kutschl/f1tenth_build/Powerboard/img_9658.jpg

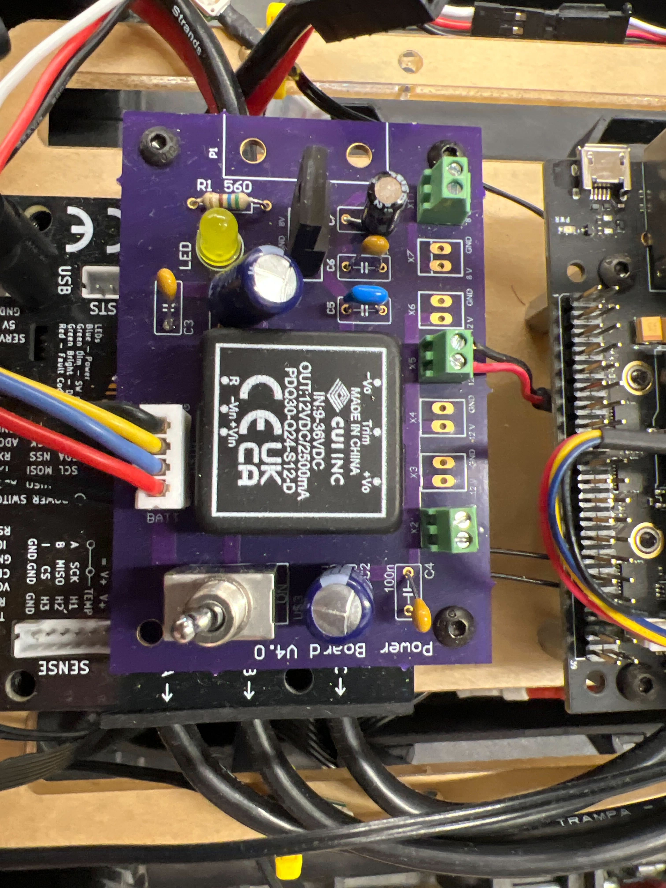
Powerboard/img_9658.jpg
