kutschl/f1tenth_build/Powerboard/IMG_9661.jpg

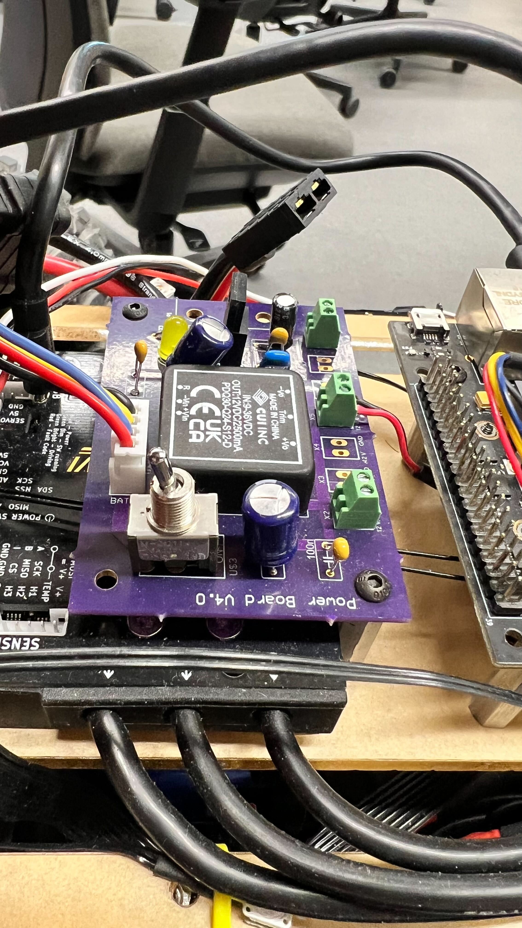
Powerboard/IMG_9661.jpg
