kutschl/f1tenth_build/Powerboard/IMG_9659.jpg

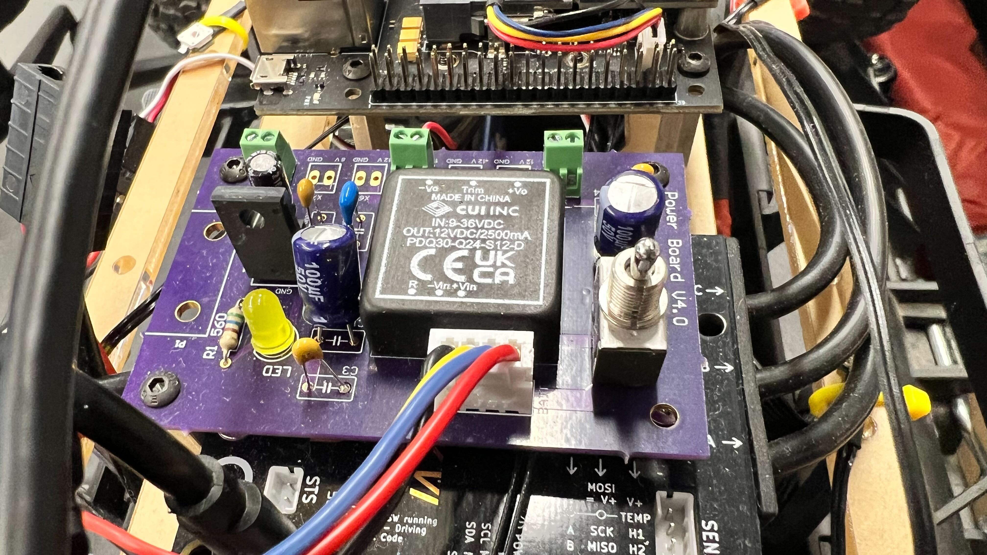
Powerboard/IMG_9659.jpg
