kutschl/f1tenth_build/Powerboard/IMG_9660.jpg

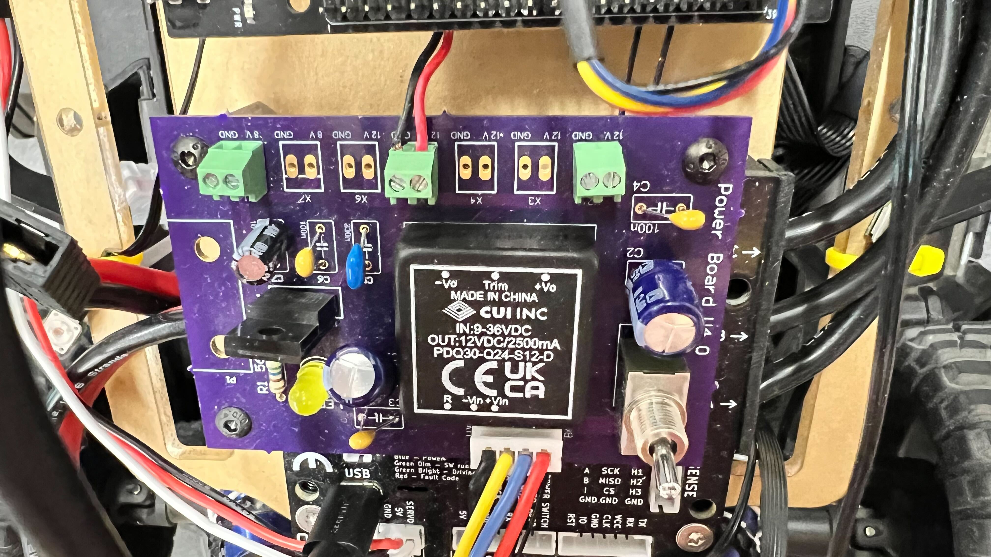
Powerboard/IMG_9660.jpg
