kutschl/f1tenth_build/Powerboard/IMG_9662.jpg

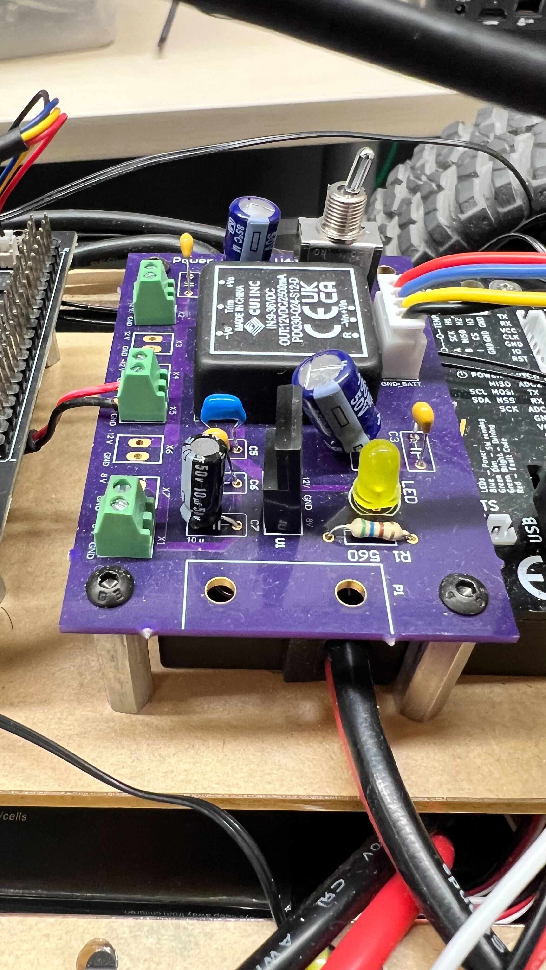
Powerboard/IMG_9662.jpg
