kutschl/f1tenth_build/BOM Orin NX.xlsx

Sheet: Orin NX Slash
Item | Qty. | Costs per Unit | Total Costs | Comments | Product Link | Shopping Link
Chassis
Traxxas TRX68077-4 Slash 4x4 Ultimate TQi 2,4GHz Link Wireless Modul, TSM | 1 | 499.95 € | 499.95 € |  | https://traxxas.com/products/models/electric/slash-4x4-ultimate | https://www.monsterhopups.de/Traxxas-TRX68086-4-Slash-1/10-4x4-Brushless-TQi-mit-Stabilitaetskontrolle-TSM
Traxxas TRX7437 Skidplate, Front | 1 | 6.26 € | 6.26 € |  | https://traxxas.com/products/parts/7437 | https://www.monsterhopups.de/Traxxas-TRX7437-Skid-Platte-vorn
Traxxas TRX7436 Body Bumper, Foam | 1 | 5.36 € | 5.36 € |  | https://traxxas.com/products/parts/7436 | https://www.monsterhopups.de/Traxxas-Schaumstoff-Stossfaenger-TRX-Rally
Traxxas TRX7415X Body mounts, front & rear/ body post, rear | 1 | 8.06 € | 8.06 € |  | https://traxxas.com/products/parts/7415X | https://www.monsterhopups.de/Traxxas-TRX7415X-Karosseriehalter-Set-vorne-hinten-fuer-Rally-VXL-1-10
Antenna Mount | 1 |  |  | self-print
Platform Deck | 1 |  |  | self-print
Depth Camera Mount | 1 |  |  | self-print
Compute Module
Computing Module: reComputer J4012 NVIDIA Jetson Orin NX Bundle 16 GB | 1 | 977.90 € | 977.90 € |  | https://www.seeedstudio.com/reComputer-J4012-p-5586.html | https://www.reichelt.de/nvidia-jetson-orin-nx-bundle-8x-2-ghz-16-gb-ddr5-jetson-orin-4012-p350587.html
WLAN Kit: Shuttle WLN-M1 | 1 | 49.95 € | 49.95 € |  | https://www.shuttle.eu/de/products/accessories/wlnm1 | https://www.reichelt.de/wlan-ax-bluetooth-kit-m-2-fuer-shuttle-barebones-shuttle-wln-m1-p329590.html
Sensors
Lidar: Hokuyo UST-20LN | 1 | 3337.18 € | 3337.18 € |  | https://hokuyo-usa.com/products/lidar-obstacle-detection/ust-20ln | https://eu.robotshop.com/de/products/hokuyo-ust-20ln-scanning-laser-obstacle-detection-sensor-eu
Depth Camera: Intel RealSense D435i | 1 | 369.00 € | 369.00 € |  | https://www.reichelt.de/tiefenkamera-intel-realsense-d435i-3d-kamera-intel-d435i-p275192.html | https://www.intelrealsense.com/depth-camera-d435i/
Electronics
ESC: Trampa VESC 6 MkVI | 1 | 267.17 € | 267.17 € |  | https://trampaboards.com/vesc-6-mkv-in-cnc-t6-silicone-sealed-aluminium-box-with-genuine-xt90-connectors--vedder-electronic-speed-controller-trampa-special-p-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 | https://trampaboards.com/vesc-6-mkv-in-cnc-t6-silicone-sealed-aluminium-box-with-genuine-xt90-connectors--vedder-electronic-speed-controller-trampa-special-p-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
Controller: SONY Dualshock 4 | 1 |  |  | for teleop |  | https://www.playstation.com/de-de/accessories/dualshock-4-wireless-controller/
Charger + LiPo Batteries: Traxxas TRX2990 Battery/Charger Complete Pack | 1 | 249.95 € | 249.95 € |  | https://traxxas.com/products/parts/2990 | https://www.monsterhopups.de/Traxxas-TRX2990GX-POWER-PACK-Dual-EZ-Peak-Plus-Ladegeraet-2x-ID-LiPo-111V-5000mah-25C
LiPo Adapter: Traxxas TRX2938X Balance Lead Adapter | 1 | 24.99 € | 24.99 € |  | https://traxxas.com/products/parts/2938X | https://www.monsterhopups.de/Traxxas-TRX2938XX-2938X-ID-Ladekabel-LiPo-Akku-auf-Balancer-Board-2S-bis-4S-XH
PPM Extension Cable: Trampa Maytech to VESC | 1 | 2.97 € | 2.97 € |  | https://trampaboards.com/maytech-to-vesc-150mm-ppm-extension-cable--silicon-cable-24-awg-blackredwhite-p-24329.html | https://trampaboards.com/maytech-to-vesc-150mm-ppm-extension-cable--silicon-cable-24-awg-blackredwhite-p-24329.html
Barrel Jack to Pigtail 12V 5A | 1 | 4.20 € | 4.20 € | connect Jetson with Powerboard |  | https://www.reichelt.de/adapterkabel-2000-mm-dc-stecker-auf-freies-ende-dc-aks-7521-p150125.html
USB to Micro-USB Cable | 1 |  |  | connect VESC with Jetson
Power Adapter: 12V 5A | 1 |  |  | for Jetson
TRX-XT90-Adapter | 1 |  |  | we soldered a TRX input to the lipo adapter instead of using the TRX-XT90-adapter
Bullet Adapter (4mm Male to 3.5mm Female) | 1 | 9.99 € | 9.99 € | connect VESC with motor |  | https://www.amazon.de/dp/B0BFHWWKX6
Misc
LiPo Safety Bag: 230 x 300 mm | 2 | 11.95 € | 23.90 € |  |  | https://www.reichelt.de/brandschutzbeutel-fuer-li-polymer-akkus-lipo-guard-xl-p207644.html
Header Pins | 1 | 0.64 € | 0.64 € | connect Servo with VESC |  | https://www.digikey.de/en/products/detail/samtec-inc/TS-103-T-A/1105491
Fasteners
Standoff M3 FF 25mm
Standoff M3 FF 35mm
Standoff M3 FF 45mm
Screw M3 10mm
Screw M5 20mm
Powerboard
PCB: F1/10 Powerboard V4.0 | 1 | 27.77 € | 27.77 € |  |  | https://oshpark.com/shared_projects/qvIKu3aY
RES 560 OHM 5% 1/4W AXIAL | 1 | 0.09 € | 0.09 € |  |  | https://www.digikey.de/short/nf19zmv4
CAP CER 0.33UF 100V X7R RADIAL | 1 | 0.52 € | 0.52 € |  |  | https://www.digikey.de/short/857dbcvr
CAP CER 0.1UF 50V X7R RADIAL | 3 | 0.21 € | 0.63 € |  |  | https://www.digikey.de/short/z0pr7pvf
CAP ALUM 100UF 20% 50V RADIAL | 2 | 0.39 € | 0.78 € |  |  | https://www.digikey.de/short/thzvmjdj
CAP ALUM 10UF 20% 50V RADIAL | 1 | 0.23 € | 0.23 € |  |  | https://www.digikey.de/short/8tjjfrt5
IC REG LINEAR 5V 1A TO220CP-3 | 1 | 1.41 € | 1.41 € | original product is not longer available: https://www.digikey.de/short/0jrzbw3b BA7808CP-E2 |  | https://www.digikey.de/short/7m437cwh
DC DC CONVERTER 12V 30W | 1 | 39.32 € | 39.32 € |  |  | https://www.digikey.de/short/dhf4chv7
TERM BLK 2P SIDE ENT 2.54MM PCB | 7 | 0.85 € | 5.95 € |  |  | https://www.digikey.de/short/r0frvb94
SWITCH TOGGLE SPST 6A 125V | 1 | 2.54 € | 2.54 € |  |  | https://www.digikey.de/short/53wnj59d
CONN HEADER VERT 4POS 2.5MM | 1 | 0.20 € | 0.20 € |  |  | https://www.digikey.de/short/fhrdjn8v
LED RED DIFFUSED T-1 3/4 T/H | 1 | 0.68 € | 0.68 € |  |  | https://www.digikey.de/short/9qcj209n
TOTAL |  |  | 5917.59 €

Sheet: Powerboard Breakdown
Item | Components | Qty.
PCB: F1/10 Powerboard V4.0 |  | 1
RES 560 OHM 5% 1/4W AXIAL | R1 | 1
CAP CER 0.33UF 100V X7R RADIAL | C5 | 1
CAP CER 0.1UF 50V X7R RADIAL | C6, C3, C4 | 3
CAP ALUM 100UF 20% 50V RADIAL | C1, C2 | 2
CAP ALUM 10UF 20% 50V RADIAL | C7 | 1
IC REG LINEAR 5V 1A TO220CP-3 | U1 | 1
DC DC CONVERTER 12V 30W | U$9 | 1
TERM BLK 2P SIDE ENT 2.54MM PCB | X1, X2, X3, X4, X5, X6, X7 | 7
SWITCH TOGGLE SPST 6A 125V | U$3 | 1
CONN HEADER VERT 4POS 2.5MM | U$10 | 1
LED RED DIFFUSED T-1 3/4 T/H | LED1 | 1

Sheet: Fasteners Breakdown
Item | Qty.
Antenna Mount to Platform
Standoff M3 FF 45mm | 2
Screw M3 10mm | 4
VESC to Platform
Screw M5 20mm | 2
Powerboard to Platform
Screw M3 10mm | 8
Standoff M3 FF 25mm | 4
Lidar to Platform
Screw M3 10mm | 4
Jetson to Platform
Standoff M3 FF 35mm | 4
Screw M3 10mm | 8
Platform to Body
Standoff M3 FF 45mm | 4
Screw M3 10mm | 8
