kutschl/f1tenth_build/Powerboard/BOM_AE170_PDU_02.04.xlsx

Sheet: BOM_AE170_PDU_02.02
Sr.# | Quantity | Designator | Description | PCB Footprint | Manu Part Number | Manufacturer | Vendor-1 | Vendor-1 Part Number | Vendor-2 | Vendor-2 Part Number
1 | 12 | C1, C11, C19, C21, C24, C28, C36, C38, C41, C43, C45, C49 | CAP CER 0.1UF 100V X7R 0603 | 0603 | CC0603KRX7R0BB104 | YAGEO | DIGIKEY | 311-1523-1-ND | MOUSER
2 | 8 | C2, C3, C6, C7, C34, C35, C44, C48 | CAP CER 10UF 50V X5R 0805 | 0805 | GRM21BR61H106KE43L | Murata Electronics | DIGIKEY | 490-18663-1-ND | FARNELL
3 | 3 | C4, C5, C8 | CAP CER 10000PF 50V X7R 0603 | 0603 | CC0603KPX7R9BB103 | Yageo | DIGIKEY | 311-1572-1-ND | FARNELL
4 | 11 | C9, C10, C12, C17, C18, C26, C27, C29, C51, C52, C53 | CAP CER 47UF 25V X5R 1206 | 1206 | C3216X5R1E476M160AC | TDK Corporation | DIGIKEY | 445-8047-1-ND | FARNELL
5 | 2 | C13, C30 | CAP CER 0.015UF 50V X7R 0603 | 0603 | CL10B153KB8NNNC | Samsung Electro-Mechanics | DIGIKEY | 1276-1277-1-ND | FARNELL
6 | 1 | C14 | CAP CER 6800PF 50V X7R 0603 | 0603 | AC0603KPX7R9BB682 | YAGEO | DIgikey | 13-AC0603KPX7R9BB682CT-ND | Element14
7 | 2 | C15, C32 | CAP ALUM POLY 82UF 20% 35V SMD | 8.3 x 8.3 | 35SVPF82M | Panasonic | DIGIKEY | P16562CT-ND | FARNELL
8 | 1 | C20 | CAP CER 100PF 50V C0G/NP0 0805 | 0805 | 08055A101JAT2A | AVX Corporation | DIGIKEY | 478-1316-1-ND | FARNELL
9 | 1 | C22 | CAP CER 270PF 50V X7R 0603 | 0603 | CC0603KRX7R9BB271 | Yageo | DIgikey | 311-1185-1-ND | Element14
10 | 2 | C23, C40 | CAP CER 1UF 50V X7R 0603 | 0603 | CC0603KRX7R9BB105 | Yageo | DIGIKEY | 311-2082-1-ND | FARNELL
11 | 2 | C25, C42 | CAP CER 47PF 50V X7R 10% 0603 | 0603 | C0603C470K5RAC7867 | KEMET | DIGIKEY | 399-16402-1-ND | FARNELL
12 | 1 | C31 | CAP CER 10000PF 50V X7R 0402 | 0402 | CGA2B3X7R1H103K050BB | TDK Corporation | DIGIKEY | 445-6893-1-ND | FARNELL
13 | 1 | C37 | CAP CER 330PF 50V C0G/NPO 0805 | 0805 | CC0805JRNPO9BN331 | YAGEO | DIgikey | 311-1117-1-ND | Element14
14 | 1 | C39 | CAP CER 82PF 50V C0G/NPO 0603 | 0603 | CC0603JRNPO9BN820 | Yageo | DIGIKEY | 311-1068-1-ND | FARNELL
15 | 1 | C46 | CAP CER 47PF 50V C0G/NP0 0402 | 0402 | CL05C470JB5NNNC | Samsung Electro-Mechanics | DIGIKEY | 1276-1699-1-ND | FARNELL
16 | 1 | C47 | CAP CER 47UF 16V X5R 1210 | 1210 | GRM32ER61C476KE15L | Murata Electronics | DIGIKEY | 490-6539-1-ND | FARNELL
17 | 1 | C50 | CAP CER 0.033UF 10V X7R 0402 | 0402 | GRM155R71A333KA01D | Murata Electronics | DIGIKEY | 490-1315-1-ND | FARNELL
18 | 2 | D1, D3 | DIODE SCHOTTKY 50V 5A SMC | DO214AB | B550C-13-F | Diodes Incorporated | DIGI-KEY | B550C-FDICT-ND | MOUSER
19 | 2 | D2, D4 | TVS DIODE 20VWM 32.4VC DO214AC | DO214AC | SMAJ20CA | Littelfuse Inc. | DIGI-KEY | SMAJ20CALFCT-ND | MOUSER
20 | 2 | D5, D8 | DIODE SCHOTTKY 50V 5A SMC | DO214AB | B550C-13-F | Diodes Incorporated | DIGI-KEY | B550C-FDICT-ND | MOUSER
21 | 4 | D6, D7, D9, D10 | DIODE SCHOTTKY 60V 2A SOD123F | SOD123F | SS26FL | onsemi | DIGI-KEY | SS26FLCT-ND | MOUSER
22 | 6 | FB1, FB2, FB3, FB4, FB5, FB6 | FERRITE BEAD 120 OHM 0805 1LN | 0805 | ABUP00201209121Y00 | Pulse Electronics | Digikey | 553-ABUP00201209121Y00CT-ND
23 | 1 | J1 | CONN HEADER SMD 4POS 2MM | HEADER-4P_2.0MM | B4B-PH-SM4-TB | JST Sales America Inc. | DIGIKEY | 455-B4B-PH-SM4-TBCT-ND | FARNELL | sunrom 6334
24 | 1 | J2 | CONN HEADER SMD 6POS 1MM | HEADER 6P | BM06B-SRSS-TB | JST Sales America Inc. | DIGIKEY | 455-BM06B-SRSS-TBCT-ND | FARNELL
25 | 4 | J3, J4, J5, J6 | EURO BLOCK 2P | HEADER-2P_3.5MM | EBWA-02-A | Adam Tech | DIGIKEY | 2057-EBWA-02-A-ND | FARNELL
26 | 2 | J7, J10 | CONN PWR JACK 2.5X5.5MM SOLDER | TH 3P | PJ-050BH | CUI Inc | DIGIKEY | CP-050BH-ND | FARNELL | sunrom 7070
27 | 1 | J8 | CONN HEADER 9PS 2.54MM | 1x9 2.54MM HEADER |  |  | DIGIKEY |  |  | Local
28 | 1 | J9 | CONN HEADER VERT 4POS 2.5MM | HEADER-4P_2.5MM | B4B-XH-A | JST Sales America Inc. | DIGIKEY | 455-B4B-XH-A-ND | FARNELL | sunrom 5225
29 | 1 | L1 | FIXED IND 3.3UH 14A 8.2 MOHM SMD | 8479 | 7443340330 | Würth Elektronik | Digikey | 732-2165-1-ND
30 | 1 | L2 | FIXED IND 2.2UH 9.7A 14.5MOHM SM | 5553 | SRP5030CA-2R2M | Bourns Inc. | Digikey | SRP5030CA-2R2MCT-ND
31 | 1 | L3 | FIXED IND 10UH 5A 21 MOHM SMD | 12.7 X 12.7 | SRR1208-100ML | Bourns Inc. | Digikey | SRR1208-100MLCT-ND | MOUSER
32 | 3 | LED1, LED2, LED3 | LED BLUE CLEAR 3MM 470NM | 0603 | LB Q39G-L2N2-35-1 | OSRAM Opto Semiconductors Inc | DIGIKEY | 475-2816-1-ND | FARNELL | 1652110
33 | 2 | Q1, Q2 | MOSFET N-CH 30V 22A 6SON | 6-SON | CSD17571Q2 | Texas Instruments | DIGIKEY | 296-37193-1-ND
34 | 2 | Q3, Q7 | MOSFET N-CH 60V 50A 8VSON | 8-VSON | CSD18537NQ5A | Texas Instruments | DIGIKEY | 296-36455-1-ND
35 | 1 | Q4 | MOSFET N-CH 100V 14.4A 6WSON | 6-SON | CSD19538Q2 | Texas Instruments | DIGIKEY | 296-47322-1-ND
36 | 3 | Q5, Q6, Q8 | MOSFET N-CH 60V 60A 8VSON | 8-VSON | CSD18543Q3A | Texas Instruments | DIGIKEY | 296-47321-1-ND
37 | 2 | R1, R14 | RES SMD 2K OHM 5% 1/10W 0603 | 0603 | ERJ-3GEYJ202V | Panasonic | DIGIKEY | P2.0KGCT-ND | FARNELL
38 | 2 | R2, R15 | RES SMD 249K OHM 1% 1/10W 0603 | 0603 | AC0603FR-07249KL | Yageo | DIGIKEY | 13-AC0603FR-07249KLCT-ND | FARNELL
39 | 1 | R3 | RES 42.2K OHM 1% 1/10W 0603 | 0603 | RC0603FR-0742K2L | Yageo | DIGIKEY | 311-42.2KHRCT-ND | FARNELL
40 | 2 | R4, R17 | RES SMD 10 OHM 1% 1/10W 0603 | 0603 | CRCW060310R0FKEA | Vishay Dale | DIGIKEY | 541-10.0HCT-ND | FARNELL
41 | 1 | R5 | RES 453K OHM 1% 1/10W 0603 | 0603 | RC0603FR-07453KL | Yageo | DIGIKEY | 311-453KHRCT-ND | FARNELL
42 | 5 | R6, R9, R19, R22, R28 | RES SMD 10K OHM 5% 1/10W 0603 | 0603 | RC0603JR-0710KL | Yageo | DIGIKEY | 311-10KGRCT-ND | FARNELL
43 | 2 | R7, R20 | RES 93.1K OHM 1% 1/10W 0603 | 0603 | RC0603FR-0793K1L | YAGEO | DIGIKEY | 311-93.1KHRCT-ND | FARNELL
44 | 2 | R8, R21 | RES 23.2K OHM 1% 1/10W 0603 | 0603 | RC0603FR-0723K2L | YAGEO | DIGIKEY | 311-23.2KHRCT-ND | FARNELL
45 | 2 | R10, R23 | RES SMD 20K OHM 5% 1/10W 0603 | 0603 | CRCW060320K0JNEA | Vishay Dale | DIGIKEY | 541-20KGCT-ND | FARNELL
46 | 4 | R11, R13, R24, R26 | RES SMD 100 OHM 1% 1/10W 0603 | 0603 | CRCW0603100RFKEA | Vishay Dale | DIGIKEY | 541-100HCT-ND | FARNELL
47 | 1 | R12 | RES 0.01 OHM 1% 3W 2512 | 2512 | PA2512FKE7T0R01E | YAGEO | DIGIKEY | 13-PA2512FKE7T0R01ECT-ND | FARNELL
48 | 1 | R16 | RES SMD 33.2K OHM 1% 1/10W 0603 | 0603 | ERJ-3EKF3322V | Panasonic Electronic Components | DIGIKEY | P33.2KHCT-ND | FARNELL
49 | 1 | R18 | RES SMD 280K OHM 1% 1/10W 0603 | 0603 | CRCW0603280KFKEA | Vishay Dale | DIGIKEY | 541-280KHCT-ND | FARNELL
50 | 1 | R25 | RES 0.018 OHM 1W 1206 WIDE | 2012 | PRL1632-R018-F-T1 | Susumu | DIGIKEY | PRL1632.018FCT-ND | FARNELL
51 | 1 | R27 | RES 52.3K OHM 1% 1/10W 0603 | 0603 | RC0603FR-0752K3L | YAGEO | DIGIKEY | 311-52.3KHRCT-ND | FARNELL
52 | 3 | R30, R31, R32 | RES 470 OHM 1/10W 5% 0603 SMD | 0603 | RC0603JR-07470RL | YAGEO | DIGIKEY | 311-470GRCT-ND | MOUSER
53 | 2 | SW1, SW2 | SWITCH TOGGLE SPDT 7.5A 125V | E101SYZQE | E101SYZQE | C&K | DIGI-KEY | CKN1519-ND | MOUSER
54 | 2 | U1, U2 | LM5176PWPR | 28-HTSSOP | LM5176PWPR | Texas Instruments | DigiKey | 296-49223-1-ND | Element14
55 | 1 | U3 | IC REG BUCK ADJ 2A SOT583 | SOT-583 | TPS62932DRLR | Texas Instruments | DigiKey | 296-TPS62932DRLRCT-ND | MOUSER
 | 127

Sheet: DNP
Sr.# | Quantity | Designator | Description | PCB Footprint | Manu Part Number | Manufacturer | Vendor-1 | Vendor-1 Part Number | Vendor-2 | Vendor-2 Part Number | Mounting
1 | 2 | C16, C33 | CAP CER 22UF 35V X5R 0805 | 0805 | C2012X5R1V226M125AC | TDK Corporation | DIGIKEY | 445-14428-1-ND | FARNELL |  | DNP
2 | 1 | R29 | RES SMD 0 OHM JUMPER 1/10W 0603 | 0603 | CRCW06030000ZSTB | Vishay Dale | DIGIKEY | 541-2971-1-ND | FARNELL |  | DNP
