kutschl/f1tenth_build/Antenna Mount/antenna_mount.SLDPRT

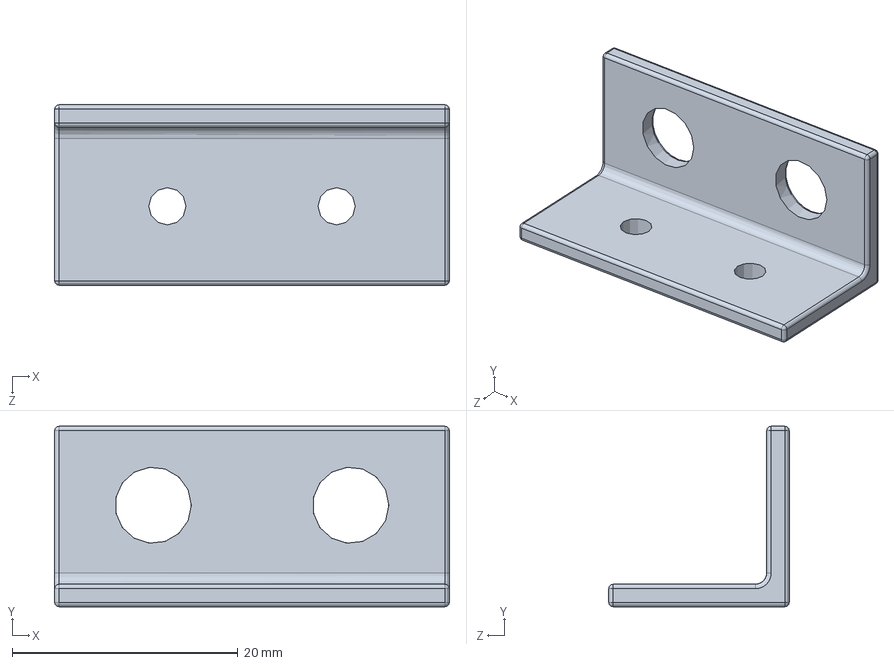
[picture p6: CAD file, 2024-07-22]
Antenna Mount/antenna_mount.SLDPRT
35.0 x 16.0 x 16.0 mm
