kutschl/f1tenth_build/Platform Deck/Platform_Deck_V3.SLDPRT

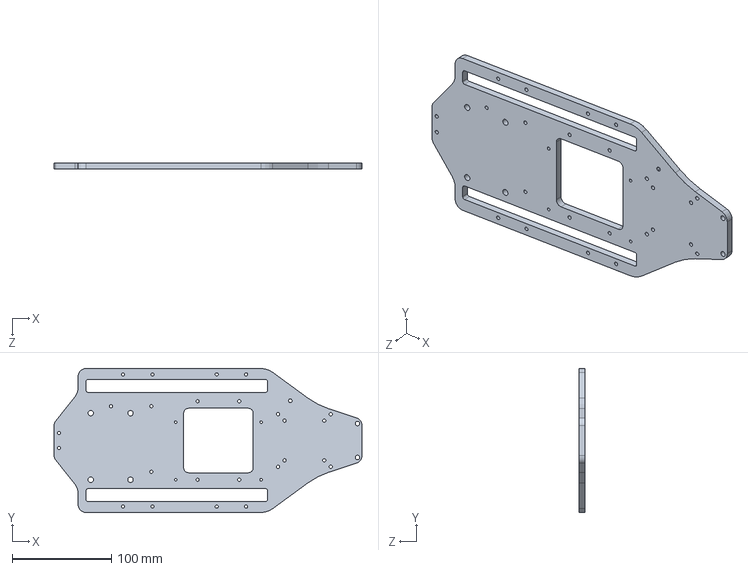
[picture p7: CAD file, 2024-07-22]
Platform Deck/Platform_Deck_V3.SLDPRT
310.0 x 145.0 x 6.35 mm
