kutschl/f1tenth_build/Powerboard/DXF_AE170_PDU_02.04.DXF

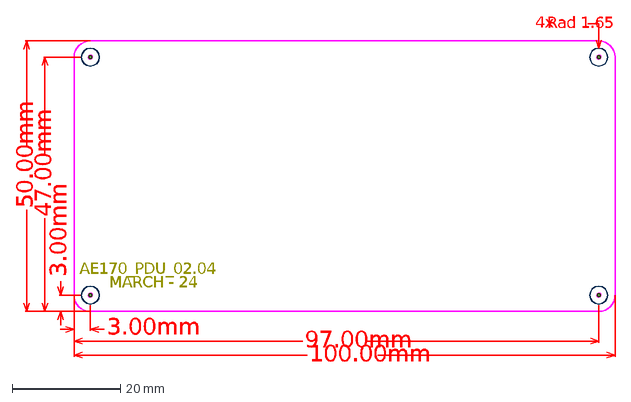
[picture p8: CAD file, 2024-07-22]
Powerboard/DXF_AE170_PDU_02.04.DXF
4x
MARCH - 24
AE170_PDU_02.04
100.00mm
50.00mm
3.00mm
97.00mm
47.00mm
Rad 1.65
