kutschl/f1tenth_build/(list of files, cad)

Other CAD files:
Antenna Mount/antenna_mount.SLDDRW
Antenna Mount/antenna_mount.STL
Platform Deck/Platform_Deck_V3.DWG
Platform Deck/Platform_Deck_V3.DXF
Platform Deck/Platform_Deck_V3.SLDDRW
Platform Deck/Platform_Deck_V3.STL
