kutschl/f1tenth_build/Powerboard/AE170_PDU_02.04.pdf

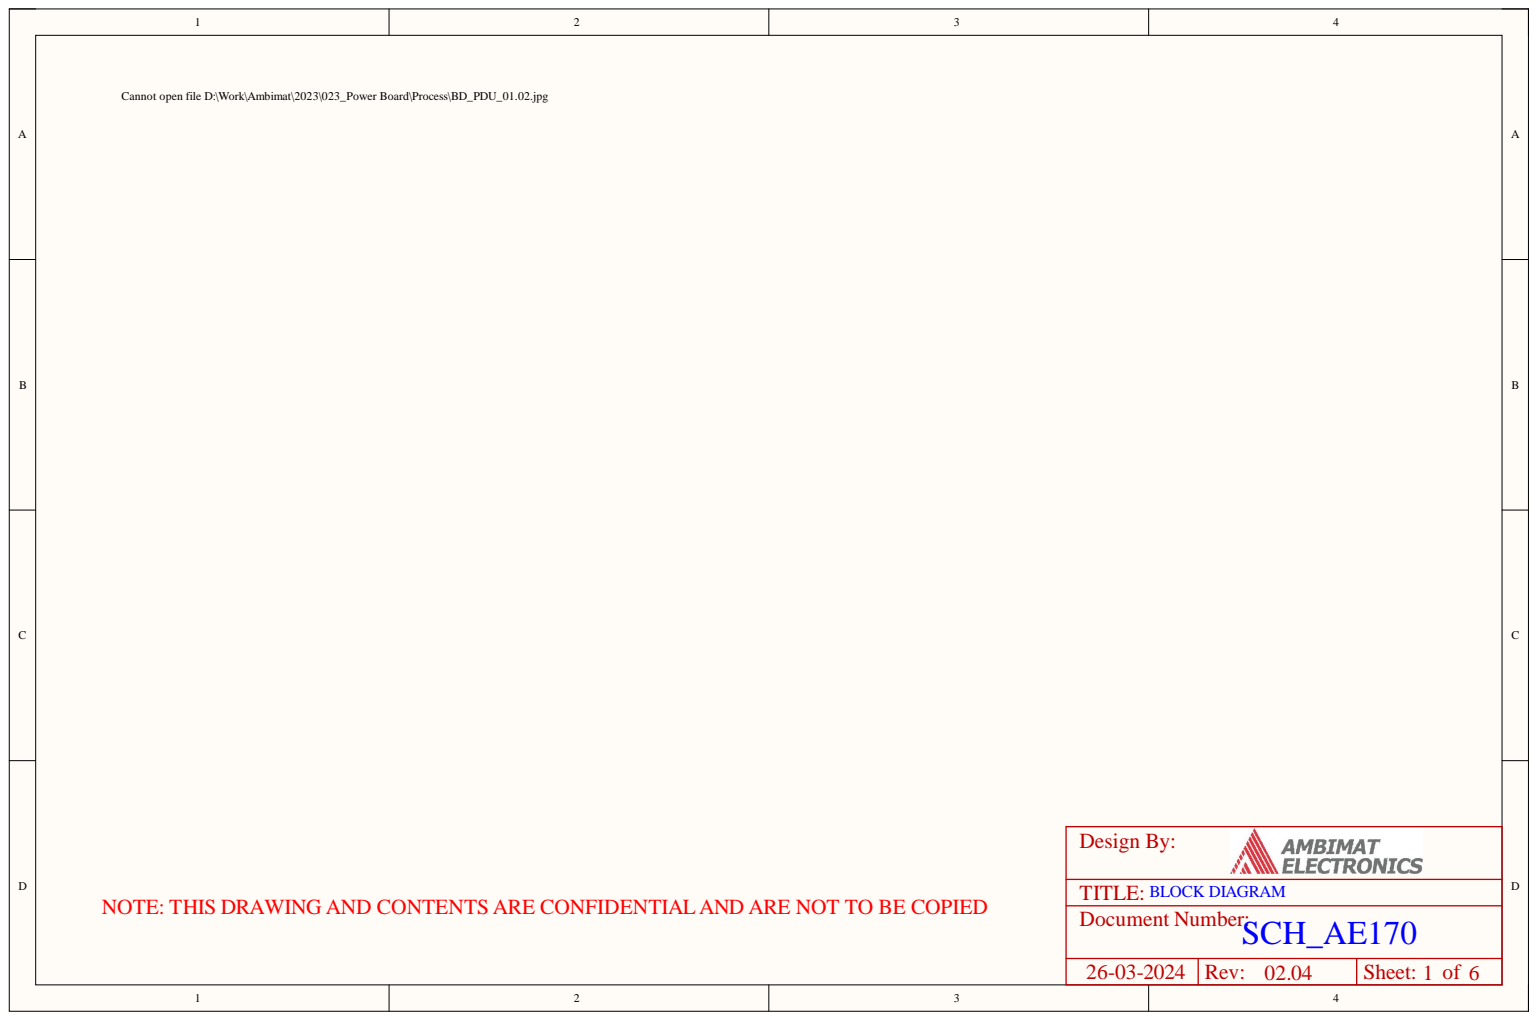
[picture p11: page 1]

Cannot open file D:\Work\Ambimat\2023\023_Power Board\Process\BD_PDU_01.02.jpg

NOTE: THIS DRAWING AND CONTENTS ARE CONFIDENTIALAND ARE NOT TO BE COPIED

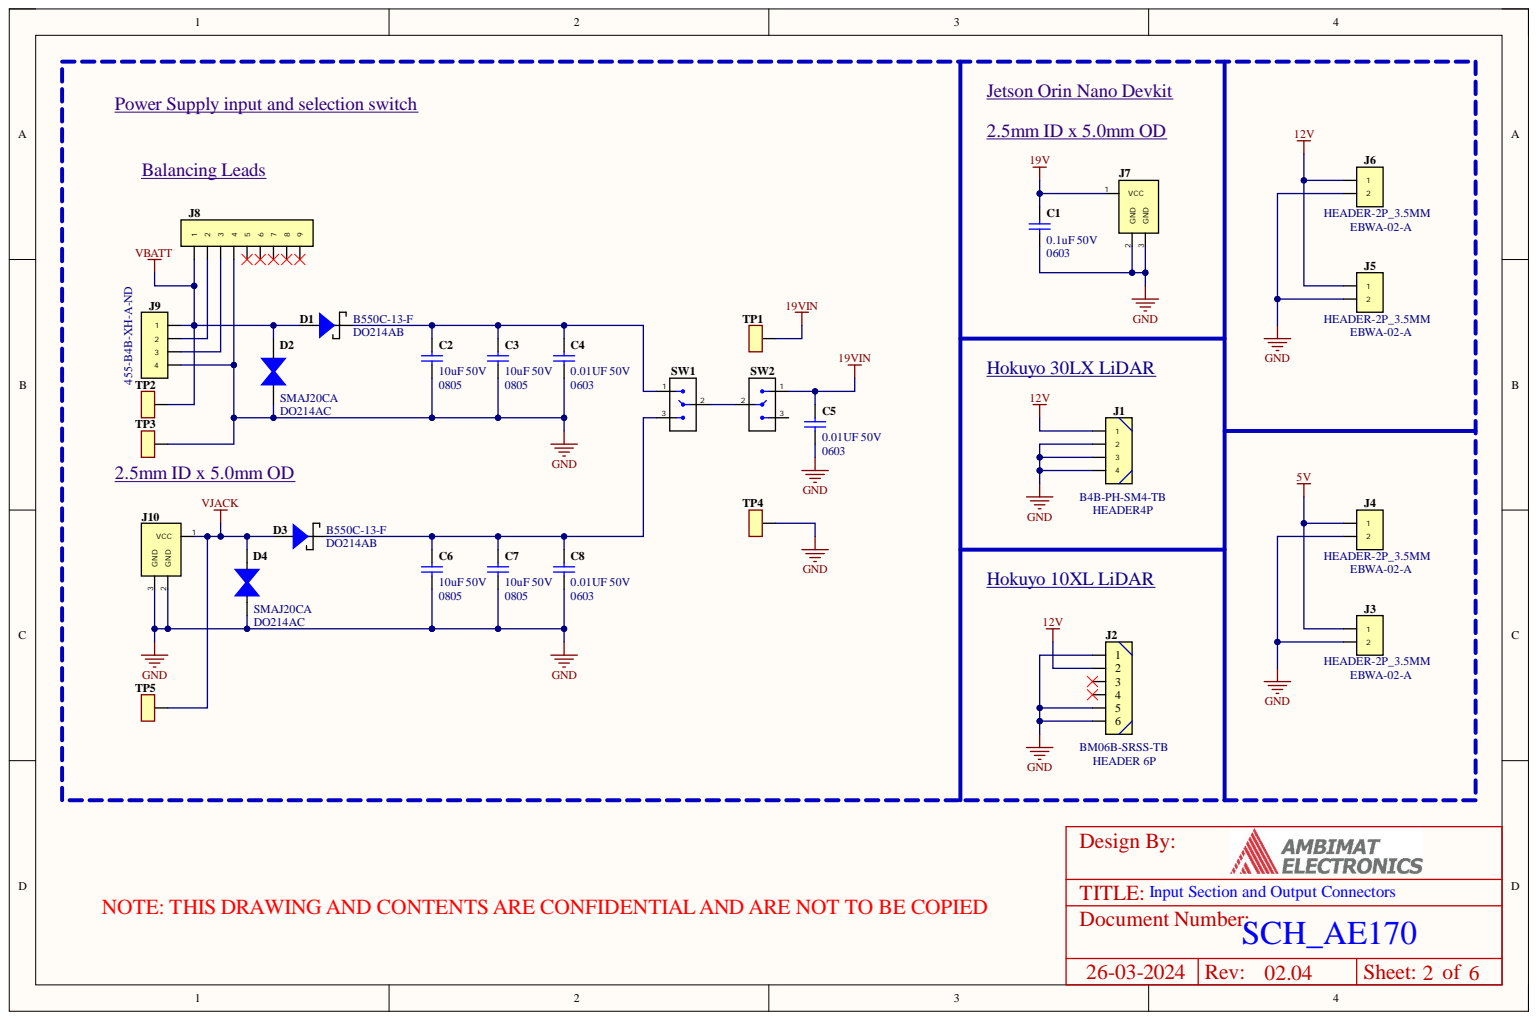
[picture p12: page 2]

ARE NOT TO BE COPIED

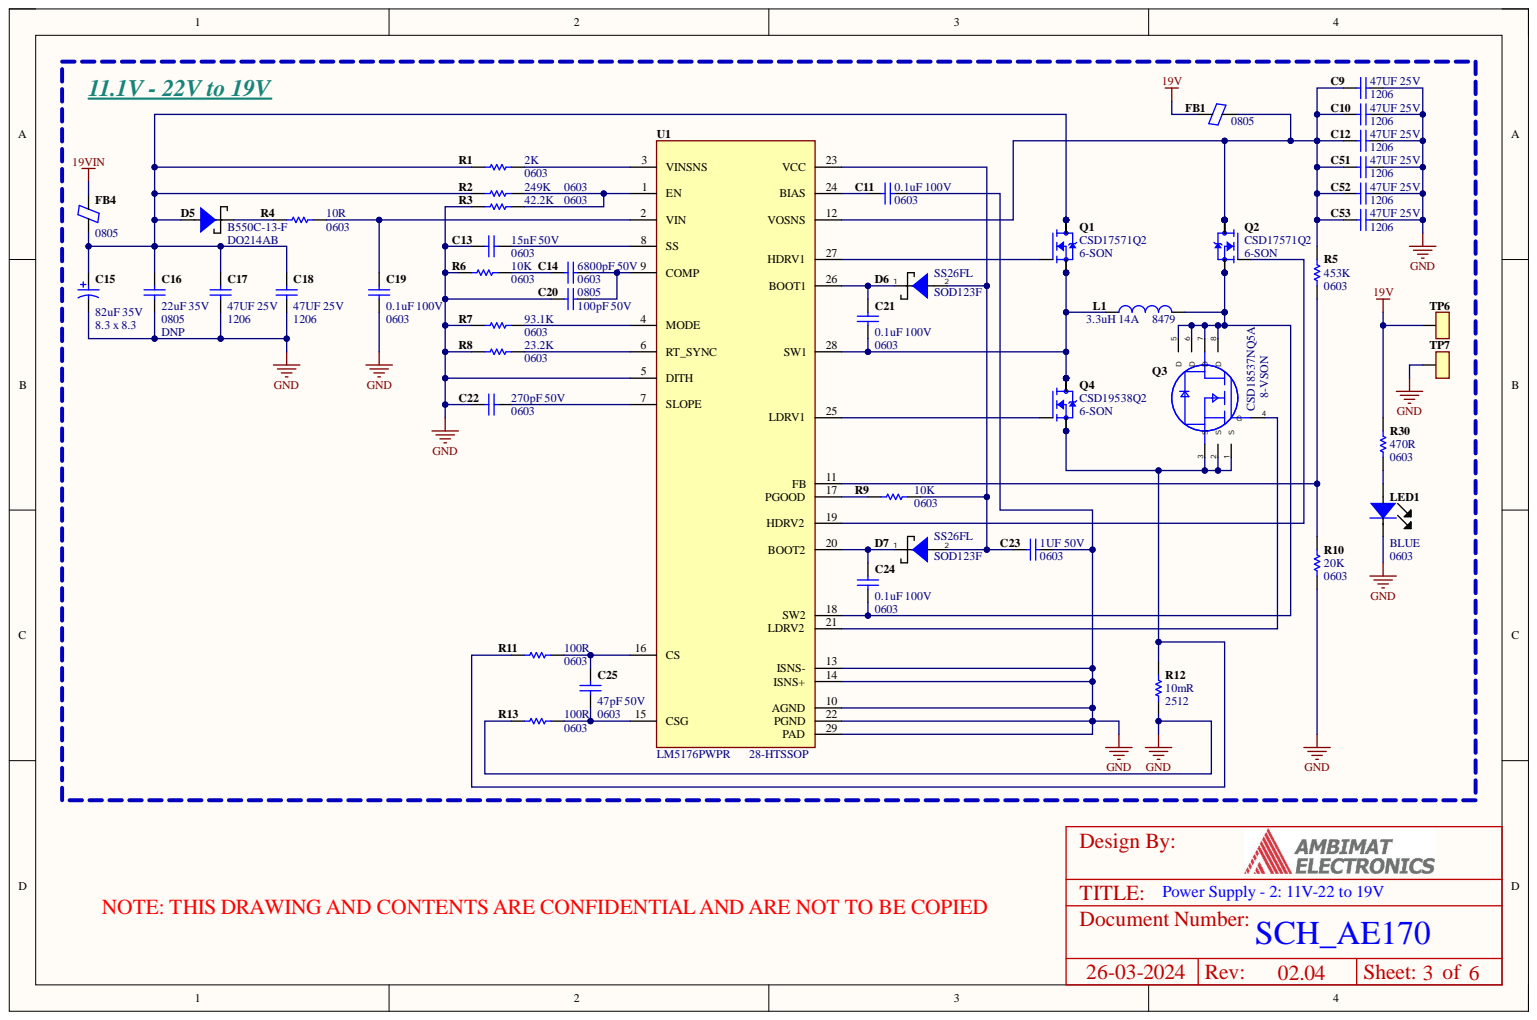
[picture p13: page 3]

2 6
2 8 | | SO D 1 2 3 F

1 1
1 7 | R 9 1 0 K
1 9 | 0 | 6 0 3

1 3
1 4

ARE NOT TO BE COPIED

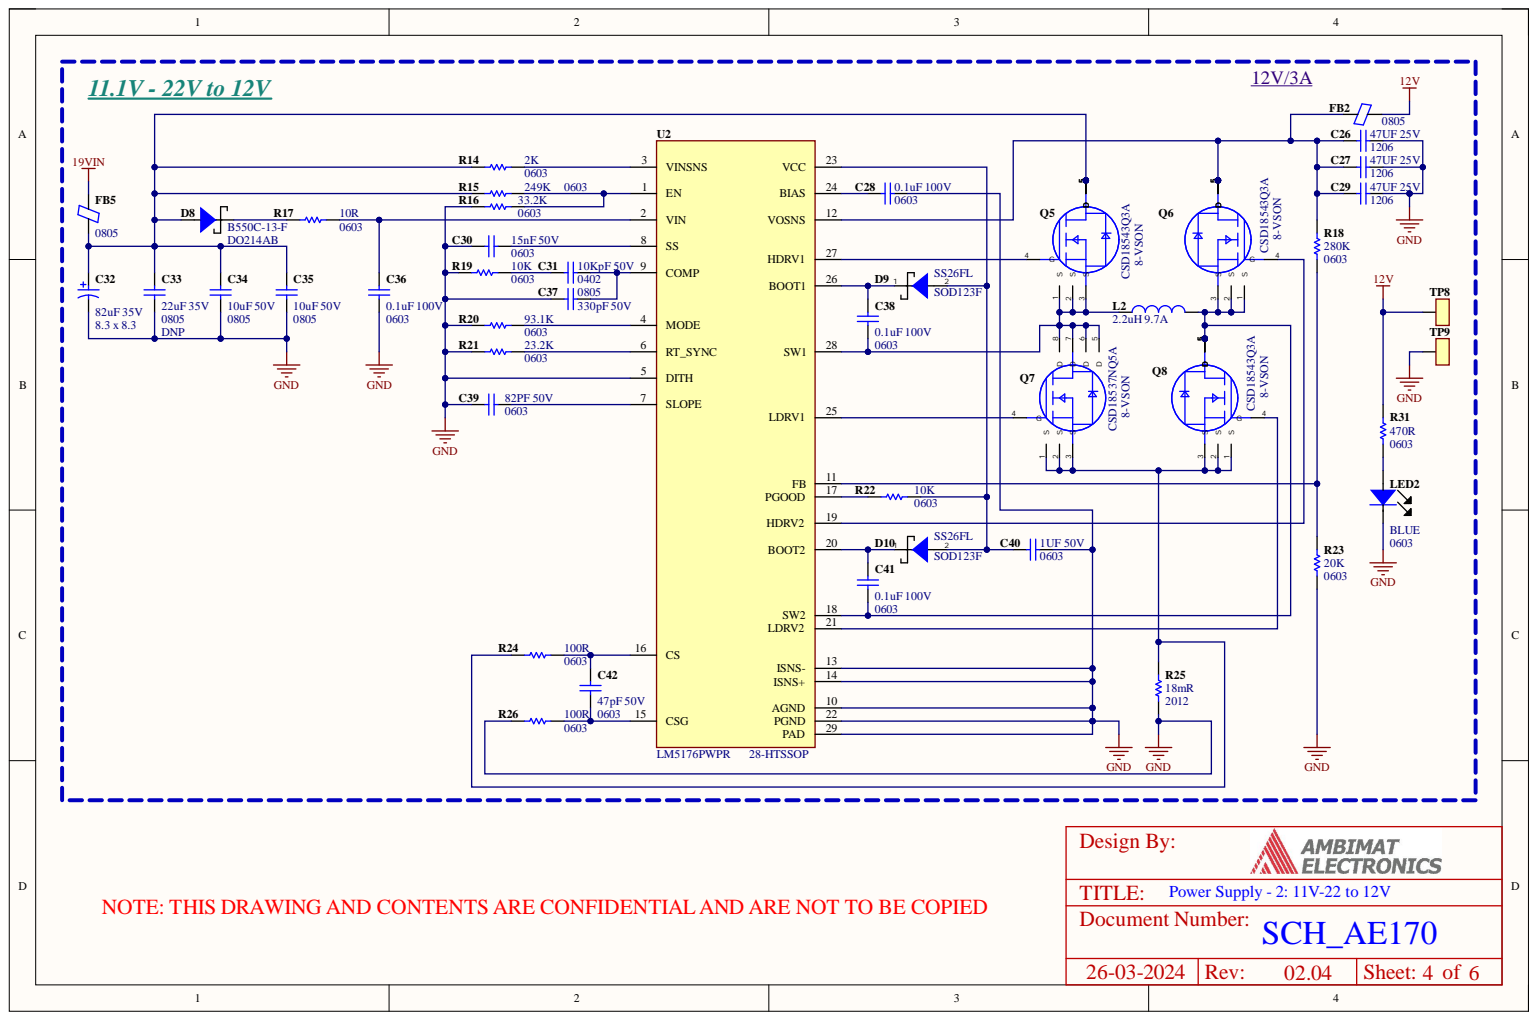
[picture p14: page 4]

1 1
1 7 | R 2 2 1 0 K
1 9 | 0 | 6 0 3

1 3
1 4

ARE NOT TO BE COPIED

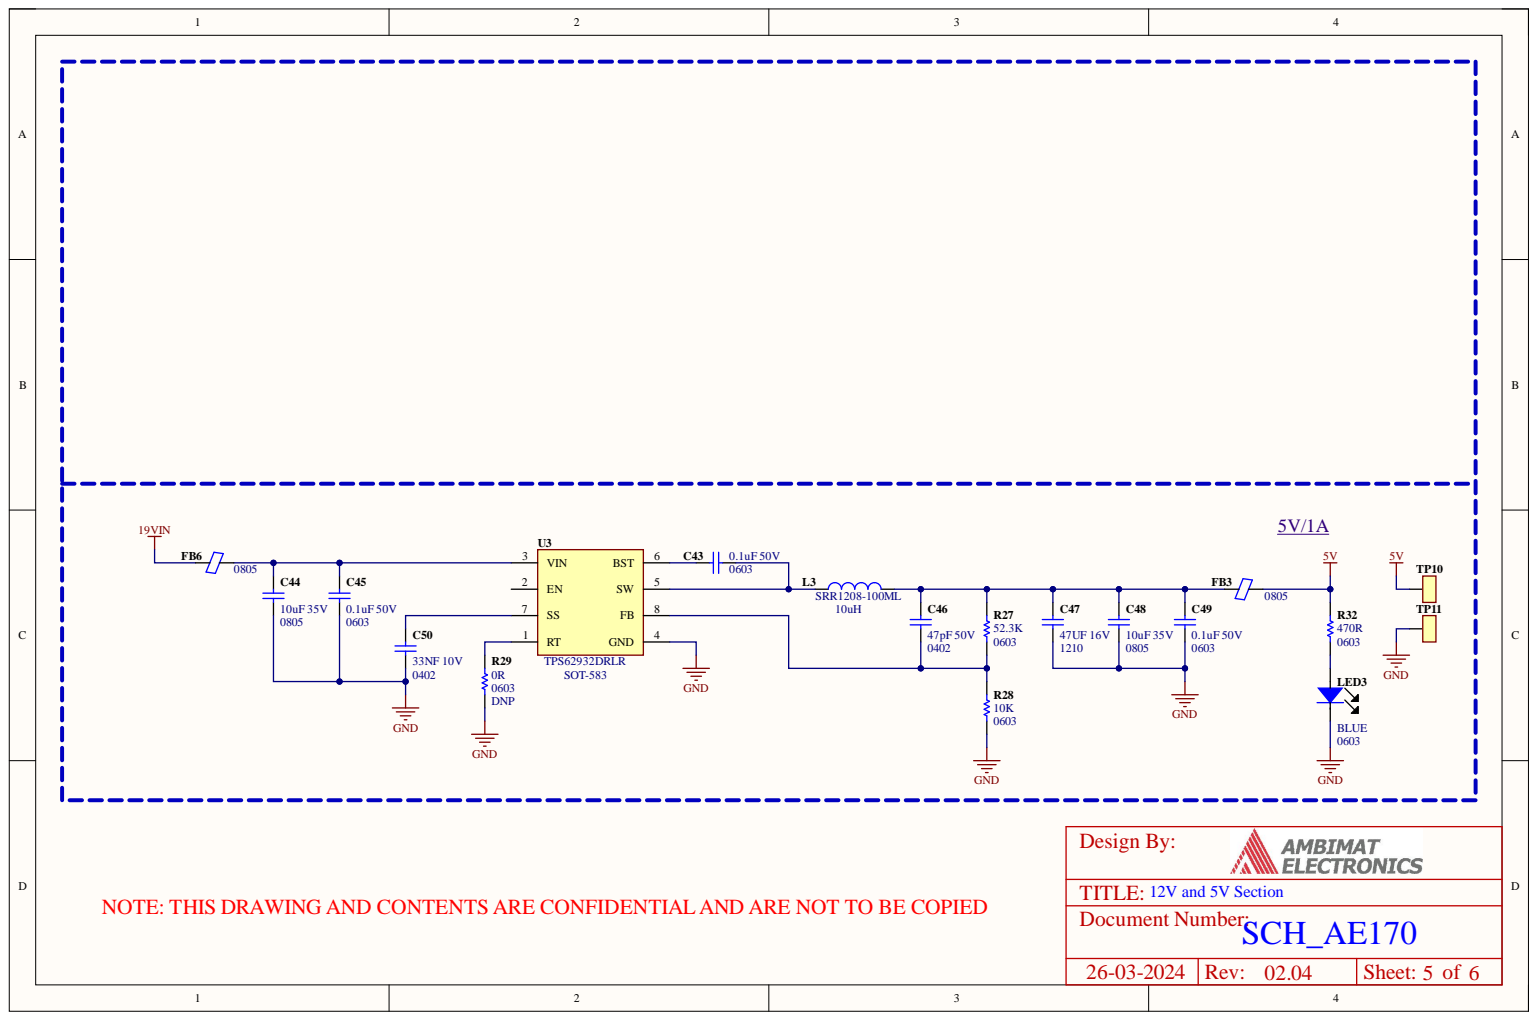
[picture p15: page 5]

ARE NOT TO BE COPIED

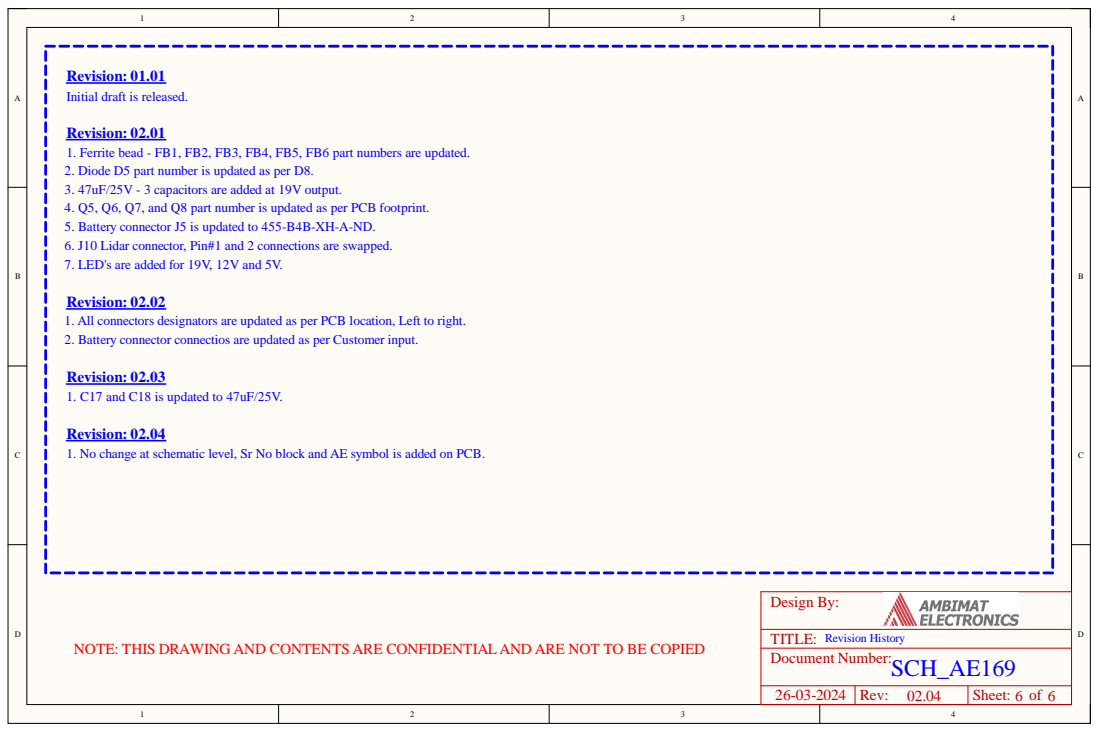
[picture p16: page 6]

Revision: 01.01
Initial draft is released.

Revision: 02.01
1. Ferrite bead - FB1, FB2, FB3, FB4, FB5, FB6 part numbers are updated.
2. Diode D5 part number is updated as per D8.
3. 47uF/25V - 3 capacitors are added at 19V output.
4. Q5, Q6, Q7, and Q8 part number is updated as per PCB footprint.
5. Battery connector J5 is updated to 455-B4B-XH-A-ND.
6. J10 Lidar connector, Pin#1 and 2 connections are swapped.
7. LED's are added for 19V, 12V and 5V.

Revision: 02.02
1. All connectors designators are updated as per PCB location, Left to right.
2. Battery connector connectios are updated as per Customer input.

Revision: 02.03
1. C17 and C18 is updated to 47uF/25V.

Revision: 02.04
1. No change at schematic level, Sr No block and AE symbol is added on PCB.

NOTE: THIS DRAWING AND CONTENTS ARE CONFIDENTIALAND ARE NOT TO BE COPIED
