kutschl/f1tenth_build/Powerboard/MECH_AE170_PDU_02.04.pdf

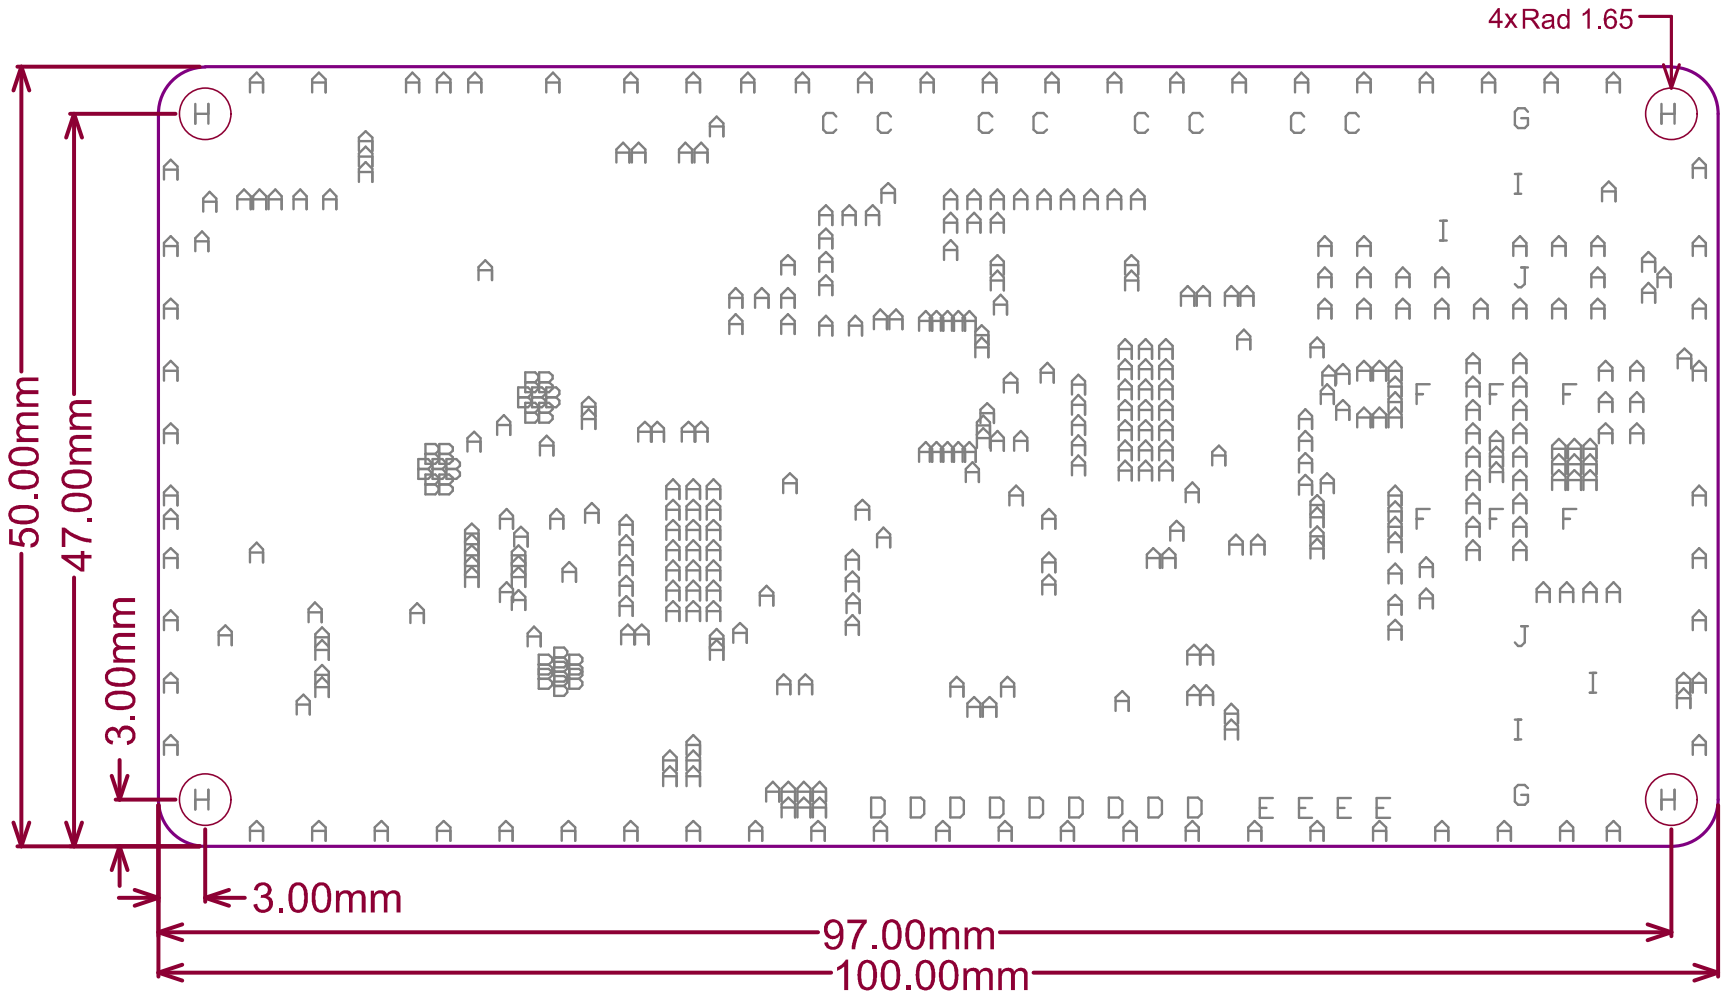
[picture p17: page 1]
