kutschl/f1tenth_build/(list of files, drawings)

Other design files:
Powerboard/Powerboard V3/Altium Project files/CS_LIB.PCBLIB
Powerboard/Powerboard V3/Altium Project files/CS_LIB.SCHLIB
Powerboard/Powerboard V3/Altium Project files/eagle-ltspice.PCBLIB
Powerboard/Powerboard V3/Altium Project files/eagle-ltspice.SCHLIB
Powerboard/Powerboard V3/Altium Project files/led.PCBLIB
Powerboard/Powerboard V3/Altium Project files/led.SCHLIB
Powerboard/Powerboard V3/Altium Project files/Power_board_teensy V2.0.PcbDoc
Powerboard/Powerboard V3/Altium Project files/Power_board_teensy V2.0.PrjPcb
Powerboard/Powerboard V3/Altium Project files/Power_board_teensy V2.0.SchDoc
Powerboard/Powerboard V3/Altium Project files/Power_board_teensy V2.01/SparkFun-Connectors.PCBLIB
Powerboard/Powerboard V3/Altium Project files/Power_board_teensy V2.01/SparkFun-Connectors.SCHLIB
Powerboard/Powerboard V3/Altium Project files/resistor.PCBLIB
Powerboard/Powerboard V3/Altium Project files/resistor.SCHLIB
Powerboard/Powerboard V3/Altium Project files/SparkFun-Connectors.PCBLIB
Powerboard/Powerboard V3/Altium Project files/SparkFun-Connectors.SCHLIB
