kutschl/f1tenth_build/VESC/vesc6_upenn_foc.xml

<?xml version="1.0" encoding="UTF-8"?>
<MCConfiguration>
    <foc_observer_gain>1.66064e+9</foc_observer_gain>
    <foc_temp_comp>0</foc_temp_comp>
    <motor_quality_bearings>0</motor_quality_bearings>
    <foc_hall_table_2>255</foc_hall_table_2>
    <foc_temp_comp_base_temp>25</foc_temp_comp_base_temp>
    <motor_model>Not Specified</motor_model>
    <motor_weight>0</motor_weight>
    <foc_sl_openloop_hyst>0.5</foc_sl_openloop_hyst>
    <m_invert_direction>1</m_invert_direction>
    <l_erpm_start>0.8</l_erpm_start>
    <foc_motor_r>0.00592</foc_motor_r>
    <l_max_erpm_fbrake_cc>30000</l_max_erpm_fbrake_cc>
    <foc_pll_kp>2000</foc_pll_kp>
    <p_pid_ki>0</p_pid_ki>
    <l_temp_motor_end>100</l_temp_motor_end>
    <p_pid_ang_div>1</p_pid_ang_div>
    <m_duty_ramp_step>0.02</m_duty_ramp_step>
    <l_slow_abs_current>1</l_slow_abs_current>
    <sensor_mode>0</sensor_mode>
    <m_encoder_counts>8192</m_encoder_counts>
    <l_battery_cut_end>8</l_battery_cut_end>
    <foc_openloop_rpm>1200</foc_openloop_rpm>
    <l_min_duty>0.001</l_min_duty>
    <l_max_erpm>30000</l_max_erpm>
    <l_min_erpm>-30000</l_min_erpm>
    <s_pid_ki>3e-5</s_pid_ki>
    <foc_duty_dowmramp_kp>10</foc_duty_dowmramp_kp>
    <foc_sl_d_current_factor>0</foc_sl_d_current_factor>
    <l_temp_motor_start>80</l_temp_motor_start>
    <foc_hall_table_0>255</foc_hall_table_0>
    <foc_encoder_inverted>0</foc_encoder_inverted>
    <sl_cycle_int_rpm_br>80000</sl_cycle_int_rpm_br>
    <s_pid_kd_filter>0.1</s_pid_kd_filter>
    <l_in_current_max>60</l_in_current_max>
    <motor_quality_description>&lt;!DOCTYPE HTML PUBLIC &quot;-//W3C//DTD HTML 4.0//EN&quot; &quot;http://www.w3.org/TR/REC-html40/strict.dtd&quot;&gt;
&lt;html&gt;&lt;head&gt;&lt;meta name=&quot;qrichtext&quot; content=&quot;1&quot; /&gt;&lt;style type=&quot;text/css&quot;&gt;
p, li { white-space: pre-wrap; }
&lt;/style&gt;&lt;/head&gt;&lt;body style=&quot; font-family:'DejaVu Sans'; font-size:11pt; font-weight:400; font-style:normal;&quot;&gt;
&lt;p style=&quot; margin-top:0px; margin-bottom:0px; margin-left:0px; margin-right:0px; -qt-block-indent:0; text-indent:0px;&quot;&gt;Some comments about the motor quality. Images can be added as well.&lt;/p&gt;&lt;/body&gt;&lt;/html&gt;</motor_quality_description>
    <hall_sl_erpm>2000</hall_sl_erpm>
    <s_pid_min_erpm>500</s_pid_min_erpm>
    <cc_ramp_step_max>0.4</cc_ramp_step_max>
    <l_current_min>-60</l_current_min>
    <m_drv8301_oc_mode>0</m_drv8301_oc_mode>
    <motor_loss_torque>0.03</motor_loss_torque>
    <foc_sample_v0_v7>1</foc_sample_v0_v7>
    <foc_encoder_ratio>7</foc_encoder_ratio>
    <sl_cycle_int_limit>62</sl_cycle_int_limit>
    <sl_max_fullbreak_current_dir_change>10</sl_max_fullbreak_current_dir_change>
    <foc_sat_comp>0</foc_sat_comp>
    <m_ntc_motor_beta>3380</m_ntc_motor_beta>
    <l_watt_min>-15000</l_watt_min>
    <foc_hall_table_6>255</foc_hall_table_6>
    <l_max_erpm_fbrake>30000</l_max_erpm_fbrake>
    <l_max_vin>57</l_max_vin>
    <motor_description>&lt;!DOCTYPE HTML PUBLIC &quot;-//W3C//DTD HTML 4.0//EN&quot; &quot;http://www.w3.org/TR/REC-html40/strict.dtd&quot;&gt;
&lt;html&gt;&lt;head&gt;&lt;meta name=&quot;qrichtext&quot; content=&quot;1&quot; /&gt;&lt;style type=&quot;text/css&quot;&gt;
p, li { white-space: pre-wrap; }
&lt;/style&gt;&lt;/head&gt;&lt;body style=&quot; font-family:'DejaVu Sans'; font-size:11pt; font-weight:400; font-style:normal;&quot;&gt;
&lt;p style=&quot; margin-top:0px; margin-bottom:0px; margin-left:0px; margin-right:0px; -qt-block-indent:0; text-indent:0px;&quot;&gt;A motor description can be edited here.&lt;/p&gt;&lt;/body&gt;&lt;/html&gt;</motor_description>
    <l_temp_fet_end>100</l_temp_fet_end>
    <l_min_vin>8</l_min_vin>
    <sl_min_erpm>150</sl_min_erpm>
    <foc_dt_us>0.08</foc_dt_us>
    <motor_poles>14</motor_poles>
    <m_fault_stop_time_ms>3000</m_fault_stop_time_ms>
    <l_max_duty>0.95</l_max_duty>
    <foc_sl_openloop_time>0.5</foc_sl_openloop_time>
    <l_watt_max>15000</l_watt_max>
    <l_abs_current_max>130</l_abs_current_max>
    <p_pid_kd_filter>0.2</p_pid_kd_filter>
    <comm_mode>0</comm_mode>
    <hall_table_6>4</hall_table_6>
    <l_in_current_min>-20</l_in_current_min>
    <motor_quality_magnets>0</motor_quality_magnets>
    <foc_sl_d_current_duty>0</foc_sl_d_current_duty>
    <foc_pll_ki>20000</foc_pll_ki>
    <cc_gain>0.0046</cc_gain>
    <pwm_mode>1</pwm_mode>
    <m_current_backoff_gain>0.5</m_current_backoff_gain>
    <motor_quality_construction>0</motor_quality_construction>
    <foc_motor_flux_linkage>0.000776</foc_motor_flux_linkage>
    <hall_table_0>-1</hall_table_0>
    <foc_hall_table_7>255</foc_hall_table_7>
    <foc_current_ki>5.92</foc_current_ki>
    <foc_hall_table_4>255</foc_hall_table_4>
    <foc_motor_l>8.6e-7</foc_motor_l>
    <foc_observer_gain_slow>0.3</foc_observer_gain_slow>
    <foc_current_filter_const>0.1</foc_current_filter_const>
    <motor_type>2</motor_type>
    <foc_encoder_offset>180</foc_encoder_offset>
    <p_pid_kd>0.0004</p_pid_kd>
    <hall_table_2>3</hall_table_2>
    <l_current_max>60</l_current_max>
    <hall_table_1>1</hall_table_1>
    <hall_table_4>5</hall_table_4>
    <foc_hall_table_1>255</foc_hall_table_1>
    <foc_f_sw>20000</foc_f_sw>
    <foc_current_kp>0.0009</foc_current_kp>
    <l_temp_accel_dec>0.15</l_temp_accel_dec>
    <hall_table_5>6</hall_table_5>
    <foc_sl_erpm>2500</foc_sl_erpm>
    <sl_min_erpm_cycle_int_limit>1700</sl_min_erpm_cycle_int_limit>
    <foc_sample_high_current>0</foc_sample_high_current>
    <m_drv8301_oc_adj>16</m_drv8301_oc_adj>
    <foc_hall_table_5>255</foc_hall_table_5>
    <foc_sensor_mode>0</foc_sensor_mode>
    <sl_phase_advance_at_br>0.8</sl_phase_advance_at_br>
    <hall_table_7>-1</hall_table_7>
    <cc_startup_boost_duty>0.05</cc_startup_boost_duty>
    <s_pid_kp>0.004</s_pid_kp>
    <m_bldc_f_sw_max>40000</m_bldc_f_sw_max>
    <motor_brand>Unnamed</motor_brand>
    <m_dc_f_sw>35000</m_dc_f_sw>
    <l_temp_fet_start>80</l_temp_fet_start>
    <m_bldc_f_sw_min>3000</m_bldc_f_sw_min>
    <l_battery_cut_start>10</l_battery_cut_start>
    <foc_hall_table_3>255</foc_hall_table_3>
    <motor_sensor_type>0</motor_sensor_type>
    <s_pid_kd>0.0008</s_pid_kd>
    <hall_table_3>2</hall_table_3>
    <foc_duty_dowmramp_ki>200</foc_duty_dowmramp_ki>
    <s_pid_allow_braking>0</s_pid_allow_braking>
    <m_sensor_port_mode>0</m_sensor_port_mode>
    <sl_bemf_coupling_k>600</sl_bemf_coupling_k>
    <p_pid_kp>0.03</p_pid_kp>
    <cc_min_current>0.2</cc_min_current>
</MCConfiguration>
